katfishkatfishing/One-Peace/Images/Box Design.png

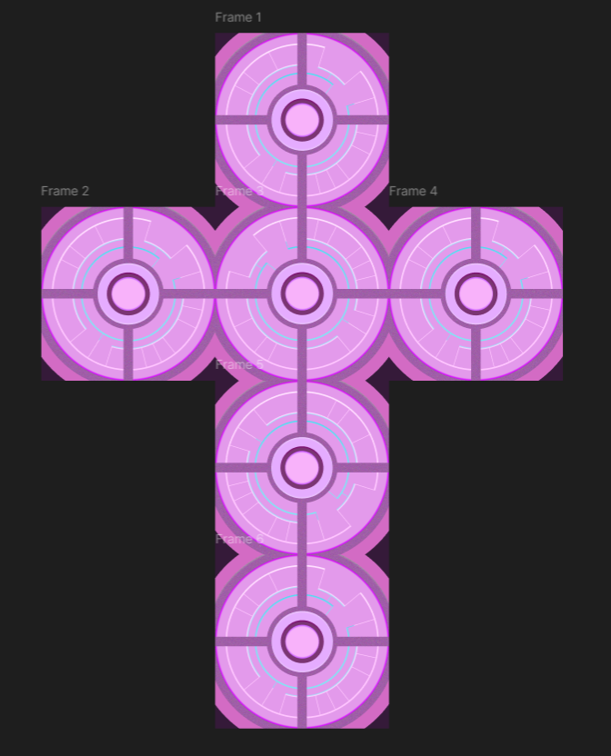
Images/Box Design.png
