katfishkatfishing/One-Peace/3D model/One Peace-One Peace Case.step

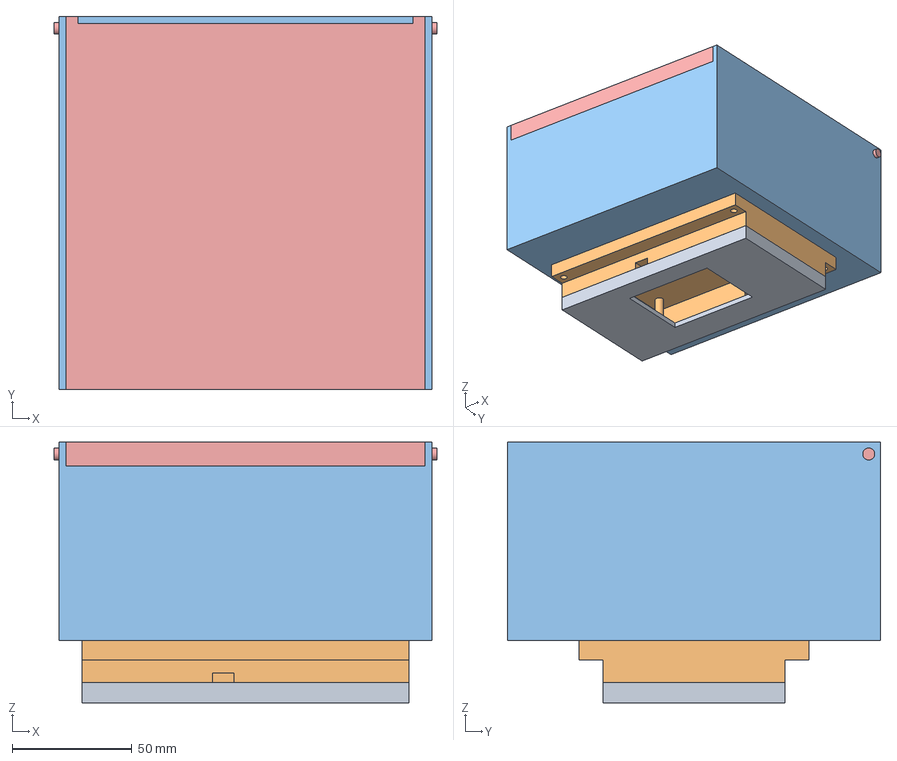
[picture p6: CAD file, 2026-11-12]
3D model/One Peace-One Peace Case.step
160.0 x 156.0 x 109.0 mm
Top_Case
Bottom_Case
Treasure_Box
Servo
Box_Door
