katfishkatfishing/One-Peace/Production file/One Peace.step

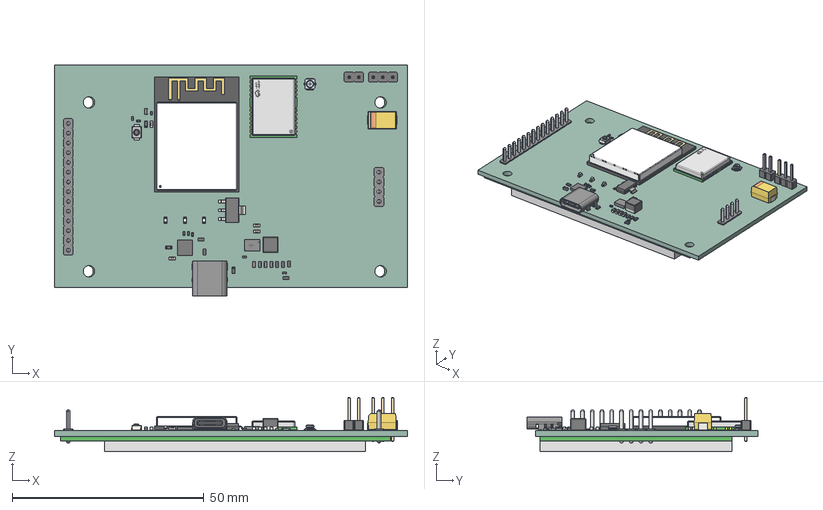
[picture p7: CAD file, 2026-09-27]
Production file/One Peace.step
92.0 x 60.3 x 14.1 mm
LED_0603_1608Metric x 3
C_0603_1608Metric x 9
VSON-14_L4.0-W3.0-H1.0-P0.50
R_0603_1608Metric x 9
PinHeader_1x03_P254mm_Vertical
uid__4030
L0201_20210301.xtd x 5
C0201_20210301.xtd x 21
ESP32-S31 - 20260402.xtd
R0201_20210301.xtd x 11
SOD882.xtd
C0402_20210301.xtd x 3
SOP8_rev1_20210308.xtd
XTAL3225_20210301.xtd
Imported
MINI-ANT-TYPE-B
S31-wroom-3-solder_pad
ShieldBox_ESP32-S31-WROOM-3_V1.1_20260514
L_APV_ANR4030
QFN-20-1EP_4x4mm_Pitch0.5mm
SW_SPST_B3U-1000P
C_0402_1005Metric x 4
USB_C_Receptacle_GCT_USB4085
SOT-223
GPSM-SMD_24P-L16.0-W12.2-P1.10
R_0402_1005Metric x 4
CP_EIA_7343_43_Kemet_X
PinHeader_1x02_P254mm_Vertical
734120110wbm000_01
LCD-TH_HS280S010B
One Peace_PCB
