katfishkatfishing/One-Peace/3D model/One Peace.FCStd

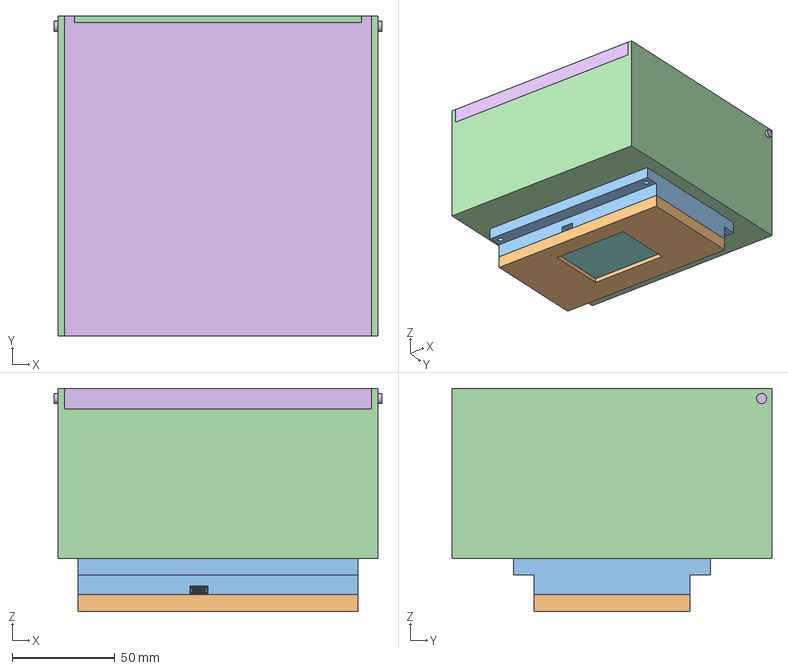
[picture p8: CAD file, 2026-09-29]
3D model/One Peace.FCStd
160.0 x 156.0 x 109.0 mm
LED_0603_1608Metric
C_0603_1608Metric
VSON-14_L4.0-W3.0-H1.0-P0.50
R_0603_1608Metric
C_0603_1608Metric002
uid__4030
L0201_20210301.xtd
C0201_20210301.xtd
ESP32-S31 - 20260402.xtd
R0201_20210301.xtd
R0201_20210301.xtd001
SOD882.xtd
C0402_20210301.xtd
L0201_20210301.xtd001
C0201_20210301.xtd001
SOP8_rev1_20210308.xtd
C0402_20210301.xtd001
C0402_20210301.xtd002
XTAL3225_20210301.xtd
R0201_20210301.xtd002
C0201_20210301.xtd002
L0201_20210301.xtd002
C0201_20210301.xtd003
C0201_20210301.xtd004
C0201_20210301.xtd005
R0201_20210301.xtd003
L0201_20210301.xtd003
R0201_20210301.xtd004
R0201_20210301.xtd005
R0201_20210301.xtd006
R0201_20210301.xtd007
L0201_20210301.xtd004
C0201_20210301.xtd006
C0201_20210301.xtd007
C0201_20210301.xtd008
C0201_20210301.xtd009
C0201_20210301.xtd010
C0201_20210301.xtd011
C0201_20210301.xtd012
C0201_20210301.xtd013
C0201_20210301.xtd014
C0201_20210301.xtd015
C0201_20210301.xtd016
C0201_20210301.xtd017
R0201_20210301.xtd008
R0201_20210301.xtd009
C0201_20210301.xtd018
C0201_20210301.xtd019
C0201_20210301.xtd020
R0201_20210301.xtd010
Imported
MINI-ANT-TYPE-B
S31-wroom-3-solder_pad
ShieldBox_ESP32-S31-WROOM-3_V1.1_20260514
L_APV_ANR4030
C_0603_1608Metric004
QFN-20-1EP_4x4mm_Pitch0.5mm
SW_SPST_B3U-1000P
C_0402_1005Metric
USB_C_Receptacle_GCT_USB4085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
