katfishkatfishing/One-Peace/(list of files, cad)

Other CAD files:
3D model/One Peace-One Peace Case.stl
