katfishkatfishing/One-Peace/Kicad Files/One Peace.kicad_pcb

## KiCad design Kicad Files/One Peace.kicad_pcb (2026-11-12)

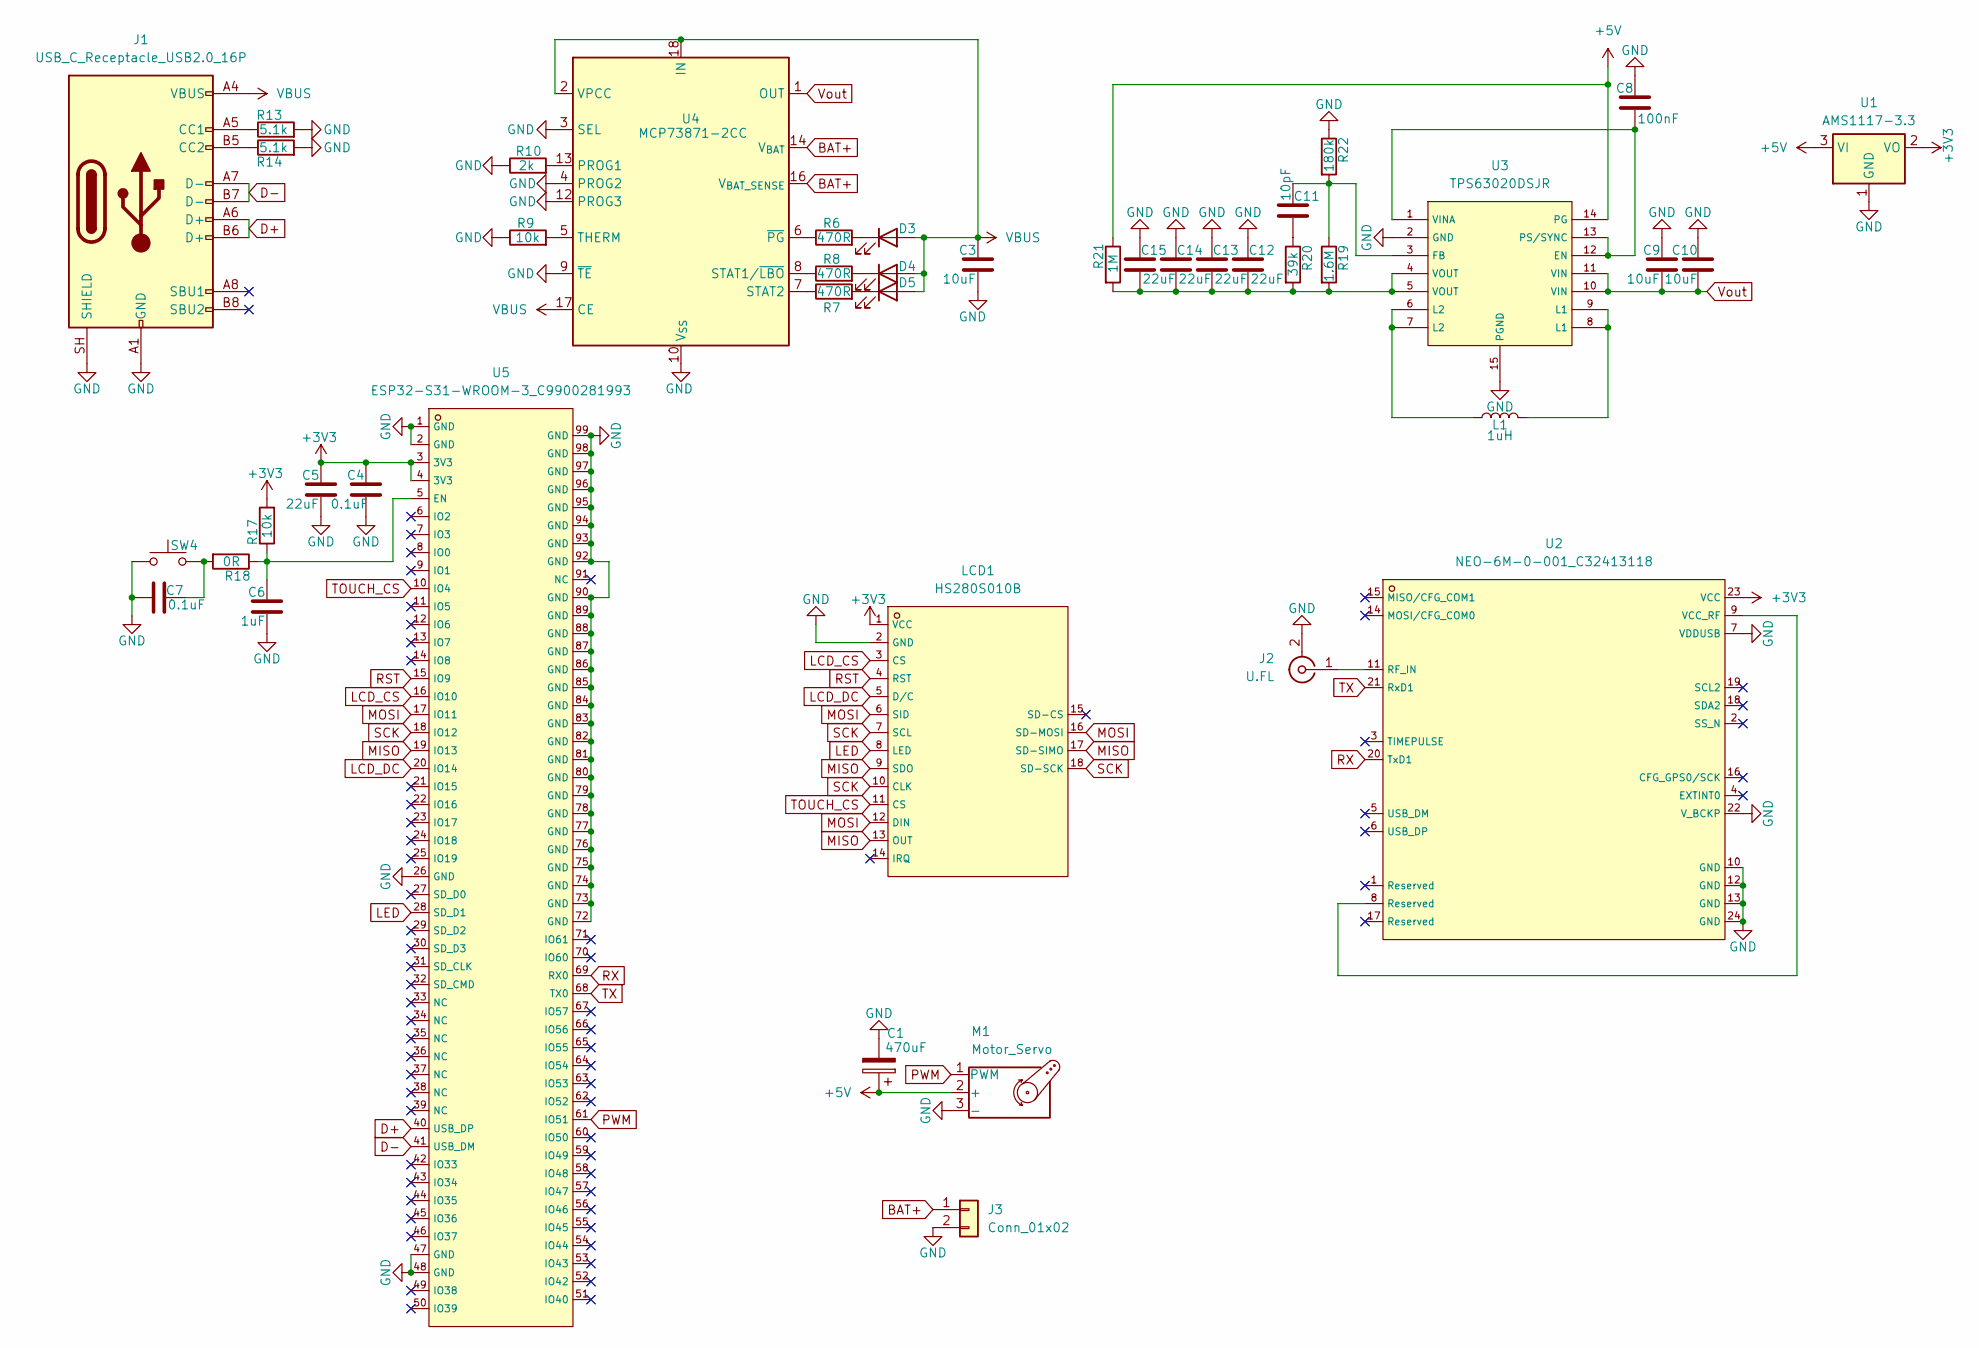
[picture p9: schematic One Peace.kicad_sch]

Parts:
C1: 470uF; CP_EIA-7343-43_Kemet-X_HandSolder
C3, C9, C10: 10uF; C_0603_1608Metric_Pad1.08x0.95mm_HandSolder
C4, C7: 0.1uF; C_0402_1005Metric_Pad0.74x0.62mm_HandSolder
C5, C12, C13, C14, C15: 22uF; C_0603_1608Metric_Pad1.08x0.95mm_HandSolder
C6: 1uF; C_0603_1608Metric_Pad1.08x0.95mm_HandSolder
C8: 100nF; C_0402_1005Metric_Pad0.74x0.62mm_HandSolder
C11: 10pF; C_0402_1005Metric_Pad0.74x0.62mm_HandSolder
D3, D4, D5: LED; LED_0603_1608Metric_Pad1.05x0.95mm_HandSolder
J1: USB_C_Receptacle_USB2.0_16P; USB_C_Receptacle_GCT_USB4085
J2: U.FL; U.FL_Molex_MCRF_73412-0110_Vertical; LCSC C5137195
J3: Conn_01x02; PinHeader_1x02_P2.54mm_Vertical
L1: 1uH; L_APV_ANR4030
LCD1: HS280S010B; C2939938_LCD-TH_HS280S010B; LCSC C2939938
M1: Motor_Servo; PinHeader_1x03_P2.54mm_Vertical
R6, R7, R8: 470R; R_0402_1005Metric_Pad0.72x0.64mm_HandSolder
R9, R17: 10k; R_0603_1608Metric_Pad0.98x0.95mm_HandSolder
R10: 2k; R_0603_1608Metric_Pad0.98x0.95mm_HandSolder
R13, R14: 5.1k; R_0603_1608Metric_Pad0.98x0.95mm_HandSolder
R18: 0R; R_0402_1005Metric_Pad0.72x0.64mm_HandSolder
R19: 1.6M; R_0603_1608Metric_Pad0.98x0.95mm_HandSolder
R20: 39k; R_0603_1608Metric_Pad0.98x0.95mm_HandSolder
R21: 1M; R_0603_1608Metric
R22: 180k; R_0603_1608Metric_Pad0.98x0.95mm_HandSolder
SW4: SW_Push; SW_SPST_B3U-1000P
U1: AMS1117-3.3; SOT-223-3_TabPin2
U2: NEO-6M-0-001_C32413118; C32413118_SMD; LCSC C32413118
U3: TPS63020DSJR; C15483_VSON-14_L4_0-W3_0-P0_50-BL-EP_TI_DSJ; LCSC C15483
U4: MCP73871-2CC; QFN-20-1EP_4x4mm_P0.5mm_EP2.5x2.5mm
U5: ESP32-S31-WROOM-3_C9900281993; C9900281993_COMM-SMD_99P-L33_0-W26_0-P0_85_ESP32-S31-MINI-1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; LCSC C9900281993

Connections:
+3V3: C4.1, C5.1, LCD1.1 (VCC), R17.2, U1.2 (VO), U2.23 (VCC), U5.3 (3V3), U5.4 (3V3)
+5V: C1.1, M1.2 (+), R21.1, U1.3 (VI), U3.14 (PG)
BAT+: J3.1, U4.14 (V_{BAT}), U4.15 (V_{BAT}), U4.16 (V_{BAT_SENSE})
D+: J1.A6 (D+), J1.B6 (D+), U5.40 (USB_DP)
D-: J1.A7 (D-), J1.B7 (D-), U5.41 (USB_DM)
GND: C1.2, C3.2, C4.2, C5.2, C6.2, C7.1, C8.1, C9.1, C10.1, C12.1, C13.1, C14.1, C15.1, J1.A1 (GND), J1.A12 (GND), J1.B1 (GND), J1.B12 (GND), J1.SH (SHIELD), J2.2 (Ext), J3.2, LCD1.2 (GND), M1.3 (-), R9.1, R10.1, R13.2, R14.2, R22.1, SW4.2, U1.1 (GND), U2.7 (VDDUSB), U2.10 (GND), U2.12 (GND), U2.13 (GND), U2.22 (V_BCKP), U2.24 (GND), U3.2 (GND), U3.15 (PGND), U4.3 (SEL), U4.4 (PROG2), U4.9 (~TE), U4.10 (V_{SS}), U4.11 (V_{SS}), U4.12 (PROG3), U4.21 (V_{SS}), U5.1 (GND), U5.2 (GND), U5.26 (GND), U5.47 (GND), U5.48 (GND), U5.72 (GND), U5.73 (GND), U5.74 (GND), U5.75 (GND), U5.76 (GND), U5.77 (GND), U5.78 (GND), U5.79 (GND), U5.80 (GND), U5.81 (GND), U5.82 (GND), U5.83 (GND), U5.84 (GND), U5.85 (GND), U5.86 (GND), U5.87 (GND), U5.88 (GND), U5.89 (GND), U5.90 (GND), U5.92 (GND), U5.93 (GND), U5.94 (GND), U5.95 (GND), U5.96 (GND), U5.97 (GND), U5.98 (GND), U5.99 (GND)
LCD_CS: LCD1.3 (CS), U5.16 (IO10)
LCD_DC: LCD1.5 (D/C), U5.20 (IO14)
LED: LCD1.8 (LED), U5.28 (SD_D1)
MISO: LCD1.9 (SDO), LCD1.13 (OUT), LCD1.17 (SD-SIMO), U5.19 (IO13)
MOSI: LCD1.6 (SID), LCD1.12 (DIN), LCD1.16 (SD-MOSI), U5.17 (IO11)
unnamed: C7.2, R18.2, SW4.1
unnamed: C11.2, R20.1
unnamed: C12.2, C13.2, C14.2, C15.2, R19.2, R20.2, R21.2, U3.4 (VOUT), U3.5 (VOUT)
unnamed: D3.1 (K), R6.2
unnamed: D4.1 (K), R8.2
unnamed: D5.1 (K), R7.2
unnamed: J1.A5 (CC1), R13.1
unnamed: J1.B5 (CC2), R14.1
unnamed: J2.1 (In), U2.11 (RF_IN)
unnamed: L1.1, U3.6 (L2), U3.7 (L2)
unnamed: L1.2, U3.8 (L1), U3.9 (L1)
unnamed: U2.8 (Reserved), U2.9 (VCC_RF)
unnamed: C8.2, U3.1 (VINA), U3.12 (EN), U3.13 (PS/SYNC)
unnamed: C11.1, R19.1, R22.2, U3.3 (FB)
unnamed: R10.2, U4.13 (PROG1)
unnamed: R8.1, U4.8 (STAT1/~LBO)
unnamed: R7.1, U4.7 (STAT2)
unnamed: R9.2, U4.5 (THERM)
unnamed: R6.1, U4.6 (~PG)
unnamed: C6.1, R17.1, R18.1, U5.5 (EN)
PWM: M1.1 (PWM), U5.61 (IO51)
RST: LCD1.4 (RST), U5.15 (IO9)
RX: U2.20 (TxD1), U5.69 (RX0)
SCK: LCD1.7 (SCL), LCD1.10 (CLK), LCD1.18 (SD-SCK), U5.18 (IO12)
TOUCH_CS: LCD1.11 (CS), U5.10 (IO4)
TX: U2.21 (RxD1), U5.68 (TX0)
VBUS: C3.1, D3.2 (A), D4.2 (A), D5.2 (A), J1.A4 (VBUS), J1.A9 (VBUS), J1.B4 (VBUS), J1.B9 (VBUS), U4.2 (VPCC), U4.17 (CE), U4.18 (IN), U4.19 (IN)
Vout: C9.2, C10.2, U3.10 (VIN), U3.11 (VIN), U4.1 (OUT), U4.20 (OUT)

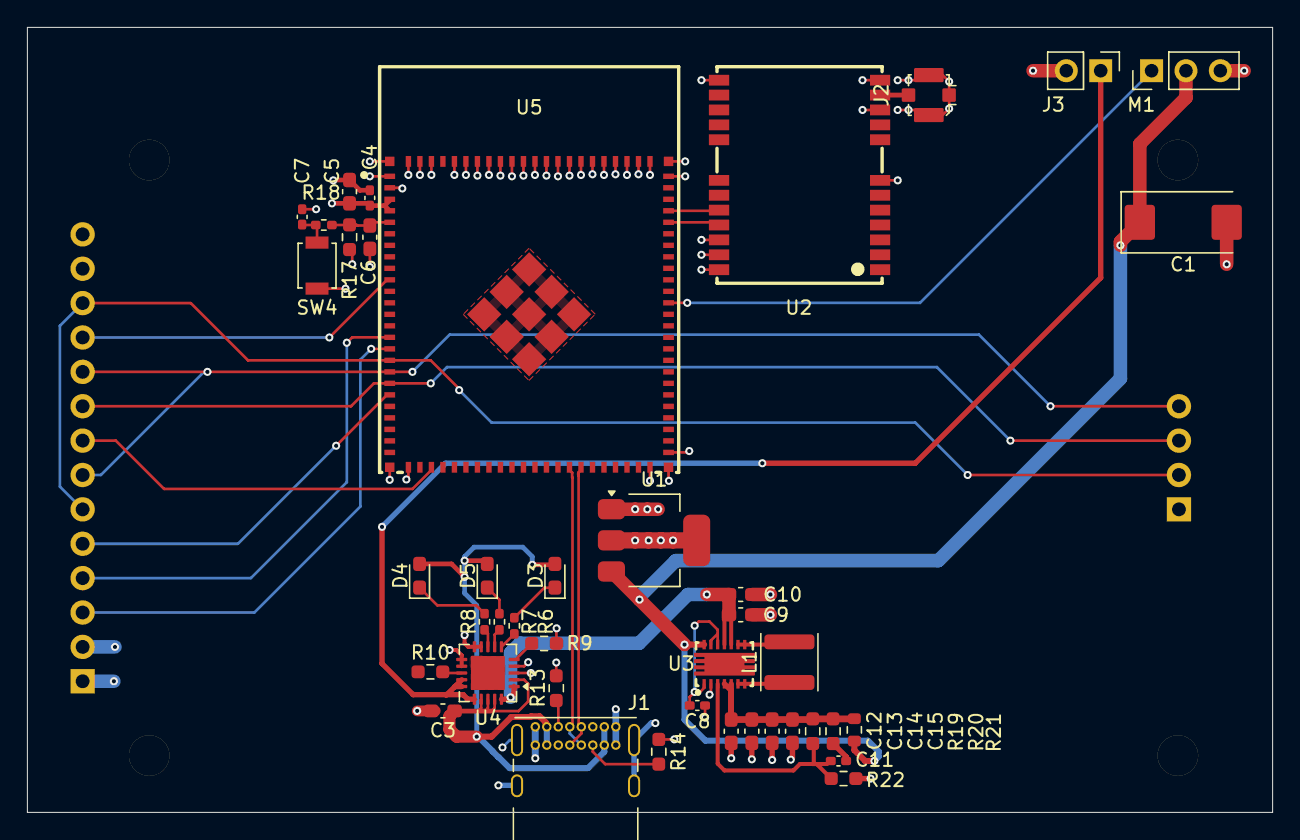
[picture p10: board One Peace.kicad_pcb from above]

Board: 4 copper layers, 92.0 x 58.0 mm, 42 parts (1 on the bottom side), 39 nets.
