katfishkatfishing/One-Peace/journal.md

23-Sep-2026
I did some research and started to get the footprint i needed. Then i also went through a little datasheet but not much. I have never used GPS ic before.

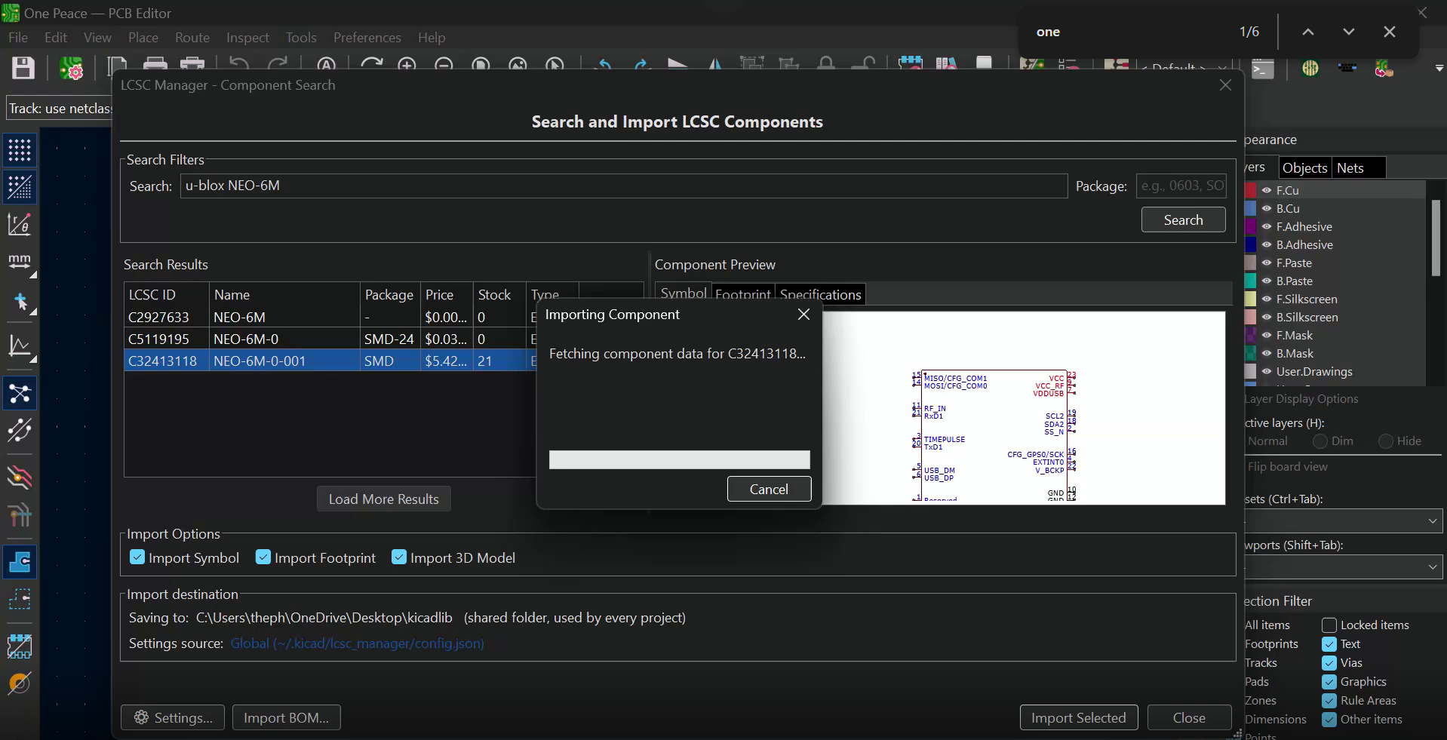
[picture p11: Images/Journal pic1.png]
Journal pic1

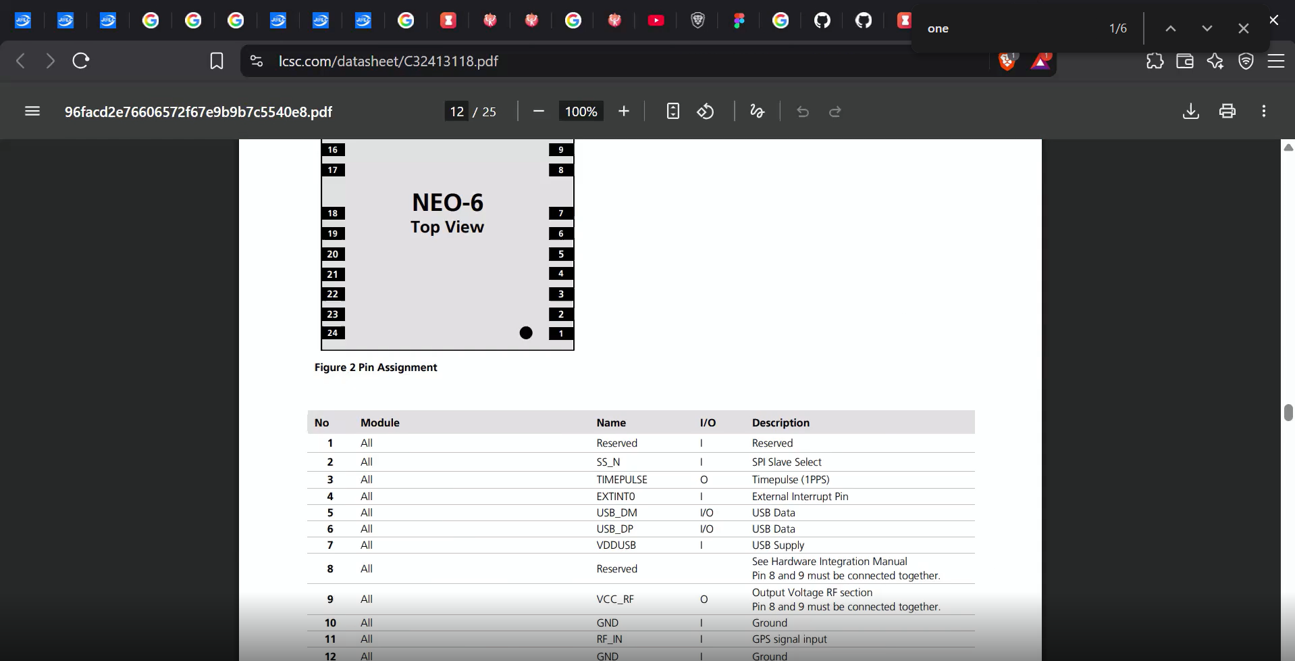
[picture p12: Images/Journal pic2.png]
Journal pic2


24-Sep-2026
I continued on going through some of the components datasheet and started to put them all into the symbol schematic. I did use Gemini helped me to find for some components and chew some datasheet synopsis that is really painful for me to understand. After that, i assigned some of the footprint that requires manual selection and did some early stage components arrangement on the pcb.

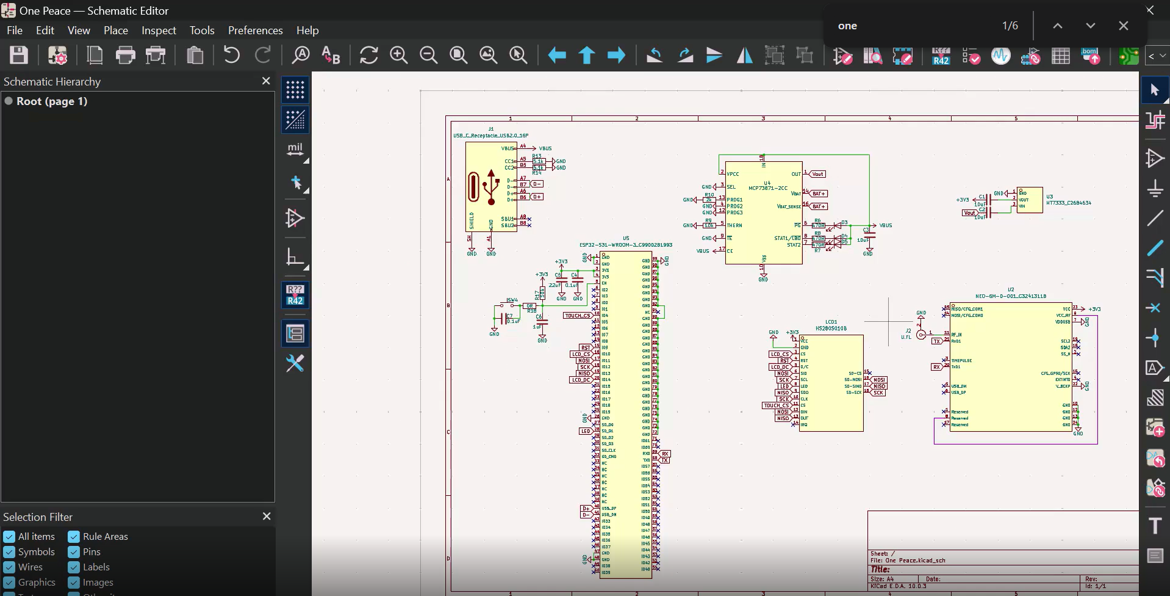
[picture p13: Images/Journal pic3.png]
Journal pic3

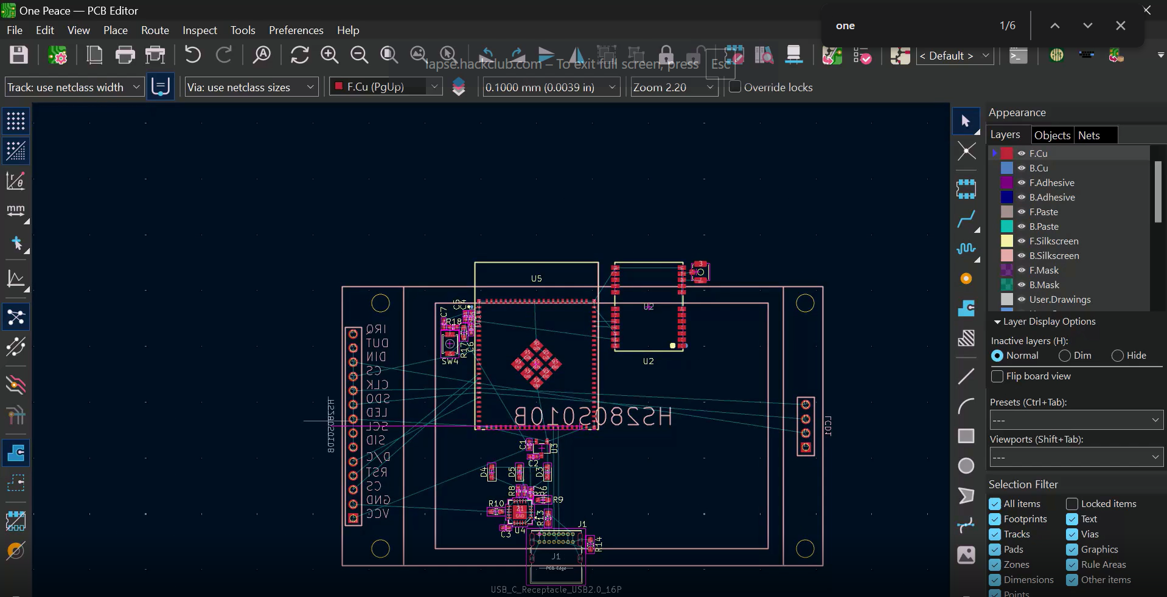
[picture p14: Images/Journal pic4.png]
Journal pic4


25-Sep-2026
A little more help from Gemini to get data for the pcb data to calculate width of traces i need for the PCB. Then i continued on routing all the components together and rearrange a little.

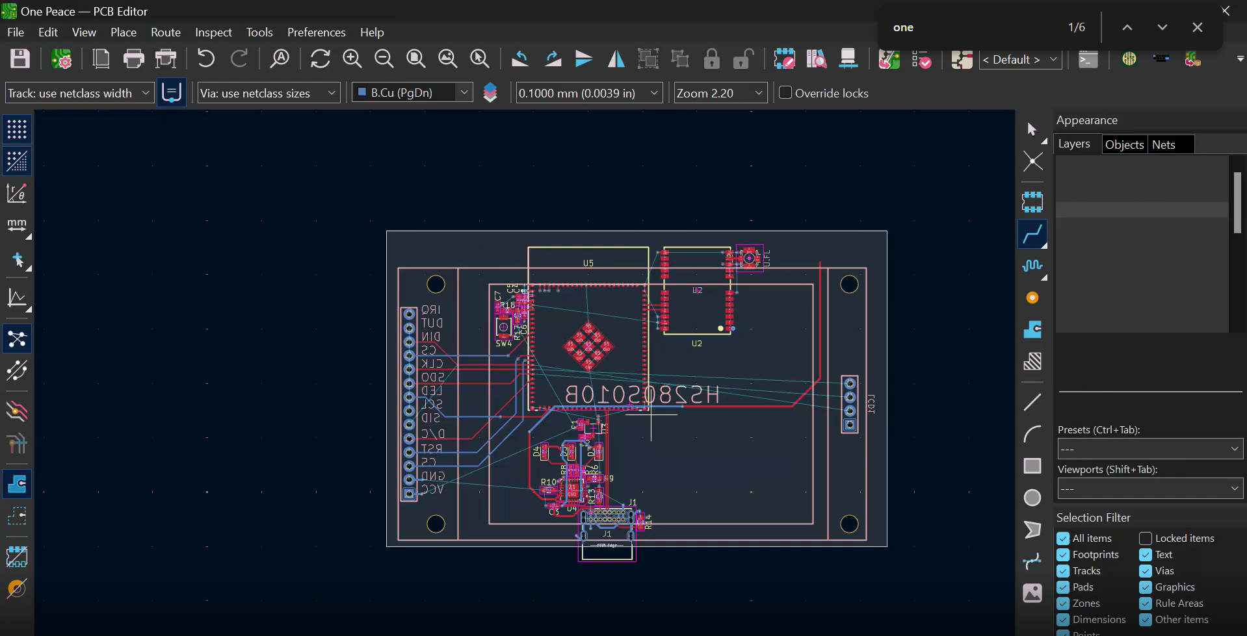
[picture p15: Images/Journal pic5.png]
Journal pic5


26-Sep-2026
Realized that the component i use couldn't supply enough power so had to change it out and add extra component for 5V(for the servo motor) and 3.3V(everything else). So had the change the schematic and slightly redo all the PCB arrangement. It wasn't too hard but the thicc trace is kinda a little too chonky. Finished the PCB part.

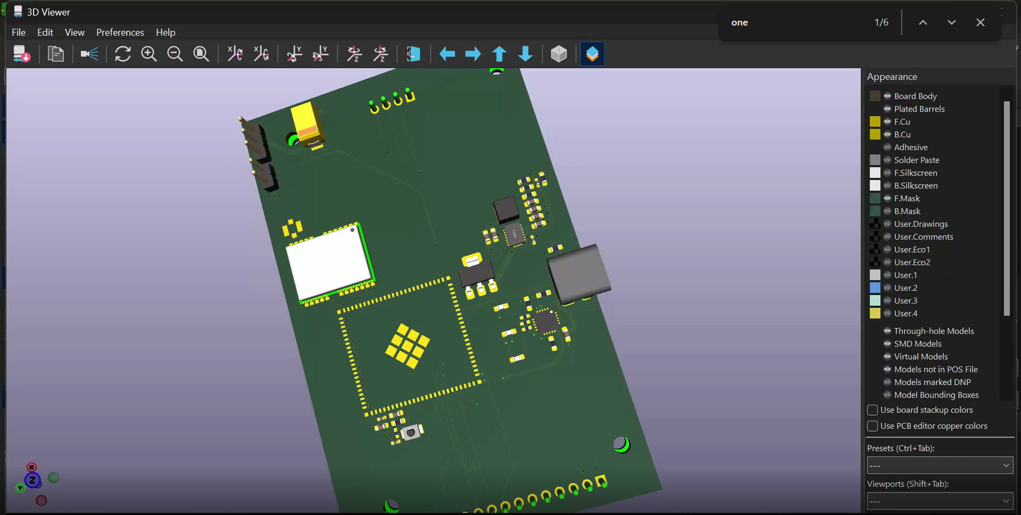
[picture p16: Images/Journal pic6.png]
Journal pic6


27-Sep-2026
Speedrunning making the case for the pcb with batteries and also the case for the treasure with the door that is open/close by a servo. It was 3am already aaaaaaaaaaa.

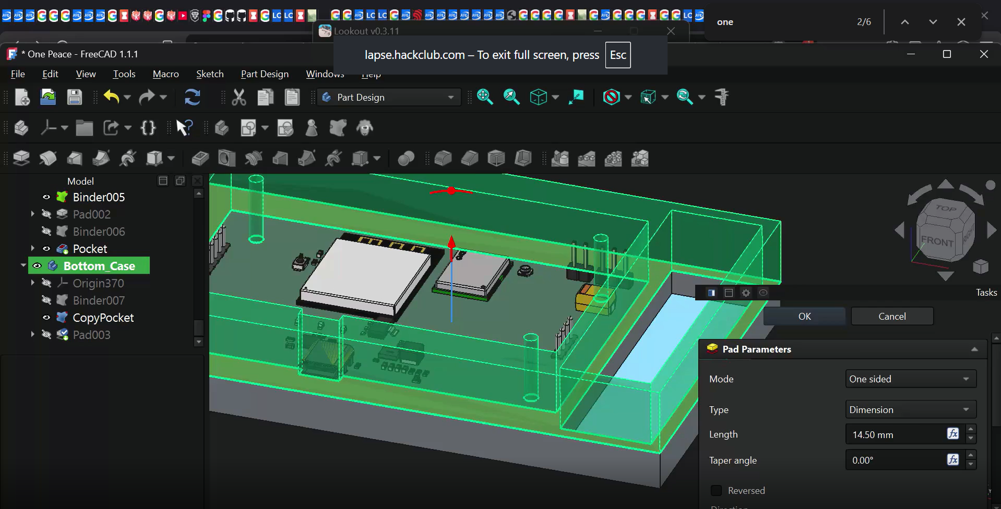
[picture p17: Images/Journal pic7.png]
Journal pic7

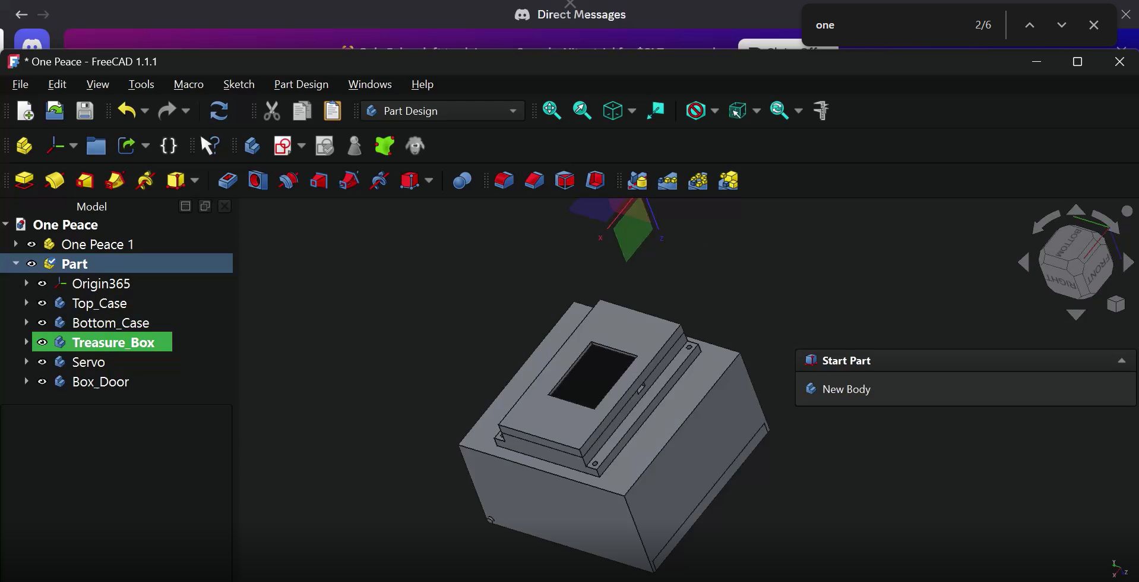
[picture p18: Images/Journal pic8.png]
Journal pic8
