katfishkatfishing/One-Peace/(commit log)

2026-09-27 Added the BOM
2026-09-27 Added BOM.csv, production files and added a components list
    [BOM.csv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]
2026-09-29 Added 3D model files, images, and production files
    [One Peace-B_Cu.gbr, One Peace-B_Mask.gbr, One Peace-B_Paste.gbr, One Peace-B_Silkscreen.gbr, One Peace-Edge_Cuts.gbr, One Peace-F_Cu.gbr, One Peace-F_Mask.gbr, One Peace-F_Paste.gbr]
2026-10-01 Updated Project overview, made key features look better, added images of pcb
2026-11-12 Added kicad files & fixed journal
